Casperdroid5/IoT-WasteBin-prototype/README.md

# WasteBin Project

Het WasteBin Project, ook bekend als de Slimme Vuilnisbak, heeft als doel het probleem van onaangename geuren in kleine leefruimtes, zoals appartementen, aan te pakken, terwijl het efficiënte afvalscheiding en milieubehoud bevordert.

Door de ontwikkeling van een uniek apparaat voorkomt dit project niet alleen onaangename geuren, maar stimuleert het ook gebruikers om verschillende soorten afval te scheiden, wat leidt tot effectievere recycling en een verminderde milieubelasting.

Dit project is ontwikkeld voor [Insyte Technology](https://insyte-technology.nl/).

Please note that the Dutch text provided above translates to English as follows:

# WasteBin Project

The WasteBin Project, also known as the Smart Wastebin, aims to tackle the problem of unpleasant odors in small living spaces, such as apartments, while promoting efficient waste separation and environmental conservation.

By developing a unique device, this project not only prevents unpleasant odors but also encourages users to separate different types of waste, leading to more effective recycling and reduced environmental impact.

This project was developed for [Insyte Technology](https://insyte-technology.nl/).

Please note that most of the text is written in Dutch on request of the company.
