Casperdroid5/IoT-WasteBin-prototype/Documentatie/mainpage.md

WasteBin project                         {#mainpage}
============

## Het creëren van een prototype slimme vuilnisbak als innovatieve oplossing voor geurvrije en milieuvriendelijke afvalverwerking

**Casper R. Tak**

Een product rapport voor het S6 project van het prototype van de slimme vuilnisbak

**Embedded Systems Engineering**
**Hogeschool van Arnhem en Nijmegen**
**Nederland**
**31/05/2023**
