Casperdroid5/IoT-WasteBin-prototype/Documentatie/mosquitto instellen.md

# Handleiding voor het opzetten van de Mosquitto Broker

Deze handleiding biedt begeleiding bij het instellen en gebruiken van de Mosquitto broker met het meegeleverde script. De Mosquitto broker maakt communicatie mogelijk tussen het apparaat en andere MQTT-clients. Volg de onderstaande instructies om de benodigde instellingen te configureren voor succesvolle communicatie.

## Vereisten

- Arduino-bord (bijv. ESP32)
- Arduino IDE
- Geïnstalleerde en actieve Mosquitto broker

## Configuratie van het script

Open het script (`.ino`-bestand) in de Arduino IDE en zoek het volgende gedeelte:

```cpp
// WiFi-instellingen
const char* SSID = "WWegvanons3";       ///< SSID van het WiFi-netwerk
const char* PASSWORD = "JuCasSan27@#";  ///< Wachtwoord voor het WiFi-netwerk

// MQTT Broker-instellingen
const char* MQTT_SERVER = "192.168.111.237";  ///< IP-adres van de MQTT broker-server
const char* MQTT_USERNAME = "mqtt";           ///< Gebruikersnaam van de MQTT broker
const char* MQTT_PASSWORD = "WasteBin5#";     ///< Wachtwoord van de MQTT broker
const int MQTT_PORT = 1883;                   ///< Poortnummer van de MQTT broker
```

1. **WiFi-instellingen**: Werk de `SSID`- en `PASSWORD`-variabelen bij met de gegevens van jouw WiFi-netwerk.

2. **MQTT Broker-instellingen**: Wijzig de `MQTT_SERVER`, `MQTT_USERNAME`, `MQTT_PASSWORD` en `MQTT_PORT`-variabelen om overeen te komen met jouw Mosquitto broker-configuratie. De `MQTT_SERVER` moet het IP-adres of de hostnaam van jouw MQTT broker bevatten.

# De instellingen van de Mosquitto Broker

Deze instellingen hebben betrekking op de algemene configuratie van de Mosquitto broker (bestand: mosquitto.conf). Laten we elk van de instellingen doornemen en hun betekenis:

- `allow_anonymous`: Deze instelling bepaalt of anonieme clients (clients zonder authenticatie) verbinding mogen maken met de broker. In dit geval is het ingesteld op `false`, wat betekent dat anonieme clients niet zijn toegestaan.

- `listener`: Deze optie specificeert het poortnummer waarop de broker luistert naar inkomende MQTT-verbindingen. De waarde `1883` geeft aan dat de broker luistert op poort 1883 voor MQTT-verkeer.

- `password_file`: Deze instelling specificeert het pad naar het wachtwoordbestand dat wordt gebruikt voor authenticatie. Het wachtwoordbestand bevat gebruikersnamen en bijbehorende wachtwoorden voor clients die verbinding mogen maken met de broker.

Door `allow_anonymous` op `false` in te stellen en een `password_file` te specificeren, zorgt de configuratie ervoor dat alleen geauthenticeerde clients met geldige referenties verbinding kunnen maken met de broker. Dit verbetert de beveiliging door ongeautoriseerde toegang te voorkomen.

Het is belangrijk op te merken dat deze instellingen deel uitmaken van de algemene configuratie en dat er mogelijk aanvullende instellingen specifiek voor de Mosquitto broker zijn die niet worden weergegeven in het verstrekte fragment.

# Verbinding maken met de Mosquitto Broker

Om het IoT-apparaat met de Mosquitto broker te verbinden, zorg ervoor dat de broker actief is en toegankelijk is vanaf het netwerk van het IoT-apparaat. Volg deze stappen:

1. **WiFi-verbinding instellen**: Het script bevat een `setupWiFi()`-functie die de verbinding met jouw WiFi-netwerk afhandelt. Het maakt automatisch verbinding met behulp van de opgegeven `SSID` en `PASSWORD`. Zorg ervoor dat het  IoT-apparaat binnen het bereik van jouw WiFi-netwerk bevindt.

2. **MQTT-client configureren**: Het script heeft een `setupMQTTClient()`-functie die de MQTT-client configureert met de opgegeven broker-instellingen. Controleer of de `MQTT_SERVER`, `MQTT_USERNAME`, `MQTT_PASSWORD` en `MQTT_PORT`-variabelen overeenkomen met jouw Mosquitto broker-configuratie.

3. **Uploaden en uitvoeren**: Upload het aangepaste script naar het  IoT-apparaat en bekijk de Seriële Monitor voor de verbindingsstatus en eventuele foutmeldingen.

4. **Verbinding verifiëren**: Nadat het script succesvol is geüpload, zou het  IoT-apparaat proberen verbinding te maken met de Mosquitto broker. Controleer de Seriële Monitor op het bericht "

WiFi connected" gevolgd door het toegewezen IP-adres van het IoT-apparaat. Als de verbinding mislukt, zorg er dan voor dat de broker-instellingen en WiFi-inloggegevens correct zijn.

## Interactie met de Mosquitto Broker

Het script voert de volgende taken uit:

- Leest sensordata uit een SHT4x-sensor.
- Update de positie van de deksel op basis van de status van een knop.
- Bestuurt een Peltier-module op basis van temperatuurfout.
- Publiceert sensordata naar de MQTT-broker.

Om te communiceren met de Mosquitto broker en gegevens te ontvangen die door het IoT-apparaat zijn gepubliceerd, heb je een MQTT-client nodig, zoals MQTT.fx, MQTT Explorer of een aangepaste toepassing.

1. **Inschrijven op sensordata**: Abonneer je in jouw MQTT-client op het onderwerp dat is gespecificeerd in de `SENSOR_DATA_TOPIC`-variabele ("/data/sensors/"). Hiermee kun je sensordata ontvangen die door het IoT-apparaat is gepubliceerd.

2. **MQTT-berichten controleren**: Bekijk in jouw MQTT-client de inkomende berichten van het IoT-apparaat op het geabonneerde onderwerp. De ESP32 zal periodiek sensordata publiceren op basis van de `msg_interval`-variabele.

## Conclusie

Door de instructies in deze handleiding te volgen, kun je de Mosquitto broker en het bijbehorende IoT-apparaat script configureren om communicatie tot stand te brengen tussen het IoT-apparaat en MQTT-clients.
