Casperdroid5/IoT-WasteBin-prototype/Documentatie/IoT oplossing.md

# Het Gebruik van meerdere ESP32-Microcontrollers met Node-Red en een Database

## Inleiding

Meerdere ESP32-microcontrollers kunnen in combinatie met Node-Red worden gebruikt om een visuele interface te bouwen op basis van de gegevens die zijn gelogd door de ESP32. Elke ESP32 kan worden geconfigureerd om gegevens van een specifieke sensor of apparaat te loggen en deze via Wi-Fi naar Node-Red te verzenden. Node-Red kan vervolgens de gegevens ontvangen en verwerken met behulp van verschillende nodes.

Al deze informatie moet vervolgens worden opgeslagen in een database, zodat de gegevens kunnen worden opgevraagd van de testpersonen en sensoren.

## Doel

Het opzetten van een systeem waarbij meerdere ESP32-microcontrollers worden gebruikt om gegevens naar Node-Red te verzenden voor visualisatie en verwerking.

Het vervolg hierop is alle gegevens vanaf Node-Red weer door te sturen naar een database.

## Onderbouwing keuze ESP32 C3

Wij kiezen voor een ESP32 omdat deze de volgende voordelen biedt:

- Relatief goedkoop (€2 per stuk).
- Beschikbaarheid (1300 op voorraad bij Mouser, afhankelijk van het model).
- Geschikt voor de taken die moeten worden uitgevoerd.
- Compact formaat.

## Waarom geen Arduino of Raspberry Pi als computer voor de WasteBin?

Raspberry Pi's zijn momenteel moeilijk verkrijgbaar, duur in aanschaf voor een testplatform en vereisen meer inspanning om op te zetten. Bovendien zijn ze vaak te krachtig voor onze doeleinden en daardoor overbodig qua rekenkracht.
Arduino's zijn redelijke alternatieven, maar duurder en beperkter dan  ESP32-modules. Desalniettemin kunnen ESP32-modules via de Arduino IDE worden geprogrammeerd met behulp van de Arduino-codebibliotheken, indien gewenst.

## Data forwarding

Data forwarding is de plaats waar alle data van de ESP32's (of vuilnisbakken) wordt verzameld. Een mogelijke optie is het gebruik van specifieke hardware, zoals een Raspberry Pi met een broker (zoals Mosquitto) en een Node-Red-dashboard.
Wij kiezen ervoor om de broker en het dashboard op onze lokale laptop te installeren in plaats van een Raspberry Pi te gebruiken. We hebben hiervoor meerdere redenen:

1. We vermijden de noodzaak van een extra apparaat (Raspberry Pi). Alles op één apparaat maakt het eenvoudiger. Bovendien zijn Raspberry Pi's moeilijk verkrijgbaar en vormen ze een extra bron van potentiële hardwarefouten (zoals SD-kaartcorruptie) en softwareproblemen (Linux-problemen) enzovoort.
2. Als we fysiek ergens anders willen werken, zouden we steeds de Raspberry Pi moeten verbinden met het netwerk op die locatie via een beeldscherm en toetsenbord.
3. De Raspberry Pi kan een beveiligingsrisico vormen.
4. Op het moment van schrijven is het erg lastig om aan Raspberry Pi's te komen i.v.m. het chip te kort.

Stappenplan:

1. ESP32-gegevens laten versturen (verbinding maken met internet).
2. Opzetten van een MQTT-broker om de gegevens door te sturen.
3. De MQTT-broker accepteert de gegevens van de ESP32.
4. De MQTT-broker stuurt gegevens door naar Node-Red (lokaal).
5. Inkomende gegevens van de MQTT-broker worden omgezet naar een dashboardweergave.
6. Data van Node-Red doorsturen naar een database.
7. De broker word op een externe computer gedraaid die dag en nacht gegevens doorzend naar Node-Red en de database

## De Data

De volgende gegevens willen we versturen vanaf de ESP32:

- Temperatuur (dubbel)
- Luchtvochtigheid (dubbel)
- Klepstand (boolean)
- Foutcodes (integer)
- WasteBin-ID (macadres)

Deze gegevens worden via MQTT naar Node-Red verzonden. Van daaruit worden de gegevens doorgestuurd naar een SQLite-database. We hebben gekozen voor SQLite vanwege de handige SQLiteStudio-omgeving waarin we de database gemakkelijk kunnen ontwerpen, opbouwen en testen.

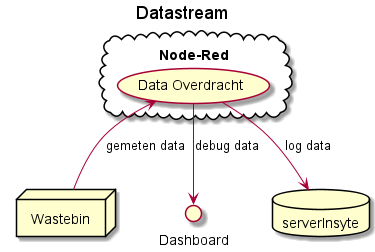
[picture p3: Documentatie/Datastream.png]
Datastream


## Meldingen voor de gebruiker

Voor onze opstelling willen we een luidspreker gebruiken als indicator die verschillende waarschuwingen kan afgeven wanneer dat nodig is. Deze waarschuwingen zijn onder andere:

- De klep staat te lang open (mogelijk)
- De binnenkant van de bak is te warm (mogelijk klep open of slechte koeling)
- Algemene fout (ander probleem)

We hebben ervoor gekozen om deze waarschuwingen ook naar ons dashboard te sturen als ze zich voordoen. Deze waarschuwingen worden weergegeven als foutcodes.

## Verstuur interval

In principe worden alle gegevens elke 15 minuten verstuurd. We denken dat dit voldoende informatie is voor elke vuilnisbak om eventuele problemen te detecteren (bijvoorbeeld te lage temperatuur). Bovendien voorkomt dit dat de database overvol raakt met gegevens, vooral wanneer er 30 vuilnisbakken zijn.

### In geval van fouten

In geval van een fout wordt dit interval genegeerd. Het interval wordt dan 2 minuten, indien er zich één of meerdere fouten blijven voordoen.

## Node-Red

We zullen Node-Red gebruiken om alle gegevens van MQTT te ontvangen, te verwerken en weer te geven. Alle ontvangen informatie wordt weergegeven via een Node-Red UI-tabblad. Dit UI-tabblad, ook wel "dashboard" genoemd in Node-Red, is uitbreidbaar indien gewenst. Alle prototype vuilnisbakken kunnen in real-time worden weergegeven op het dashboard als dat gewenst is.

De Node-Red UI ziet er als volgt uit voor twee vuilnisbakken:

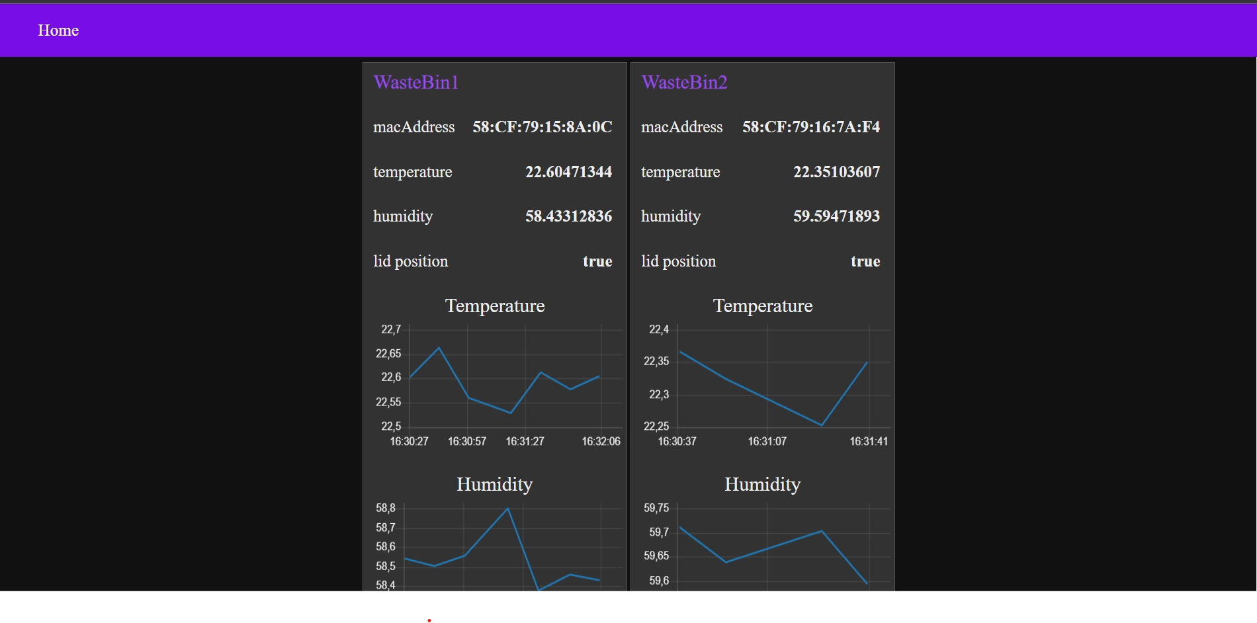
[picture p4: Documentatie/node-red-ui.png]
Node-Red UI


### Node-Red flow

Om dit alles te laten werken, hebben we een Node-Red flow gemaakt. De Node-Red flow ziet er als volgt uit:

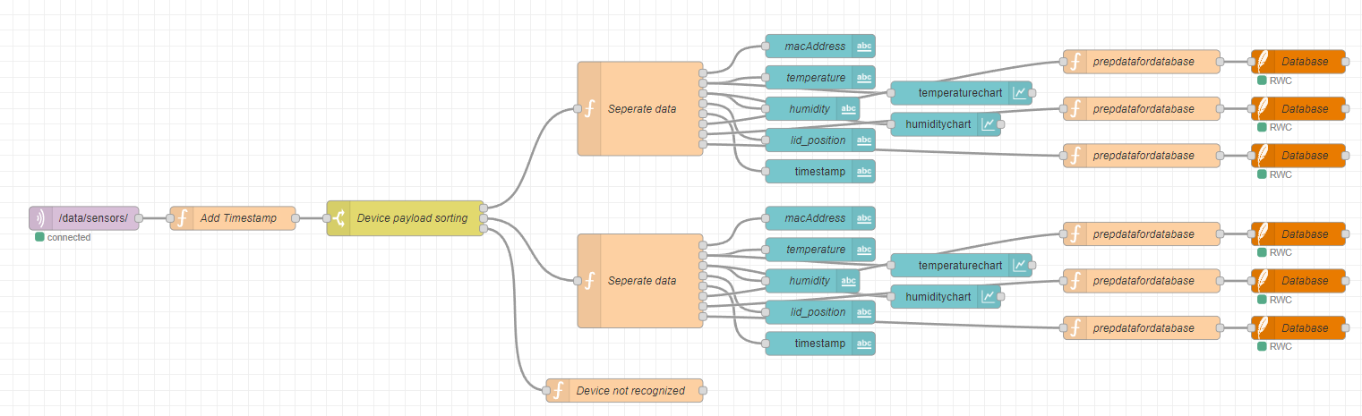
[picture p5: Documentatie/node-red-setup.png]
Node-Red setup


In deze flow ontvangt de eerste node (paars) de MQTT-gegevens. Vervolgens wordt er een tijdstempel aan het bericht toegevoegd en worden alle inkomende berichten gescheiden met behulp van een schakelaar (switch). De gegevens worden gescheiden op basis van het macadres (uniek) van de vuilnisbak.

Nadat de berichten zijn gescheiden, komen ze in een grote functieblok (oranje) dat het bericht analyseert en verdeelt over de uit puts van het functieblok. Ik heb hiervoor gekozen, zodat het functieblok modulair blijft en de uitvoer flexibel is. De uitvoer wordt gestuurd naar dashboardblokken (blauw) en naar nieuwe functieblokken die extra gegevens toevoegen (zoals sensor-ID) en deze als query naar een SQLite-database sturen.

# Database

Alle informatie wordt via Node-Red doorgestuurd naar een SQLite-database. Het doel van de database is om een doorzoekbare geschiedenis van alle ontvangen gegevens van de vuilnisbakken te creëren en een overzicht te bieden van alle gebruikers (testpersonen) en hun gegevens.

De database is als volgt opgebouwd:

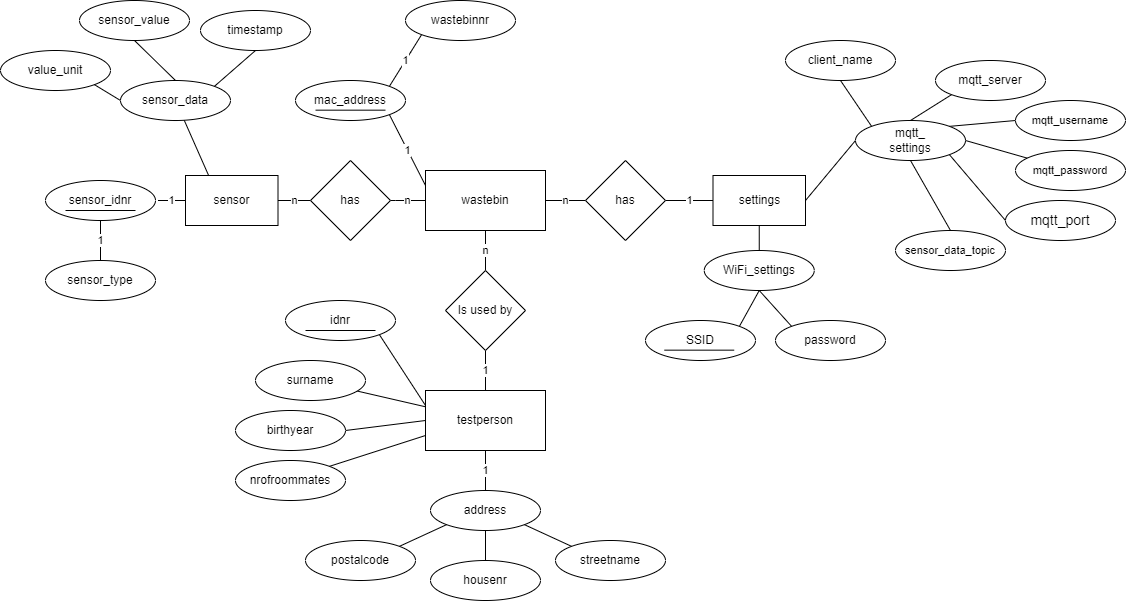
[picture p6: Documentatie/WasteBinDBER.png]
Databaseontwerp


Hierbij zijn alle onderstreepte woorden sleutelwaarden. Helaas toont het Database Entity Relationship-diagram (DBER) niet alle details, maar het geeft wel een goed overzicht van de databasestructuur.

## sensor Table

| Column Name | Data Type | Constraints |
| --- | --- | --- |
| sensor_idnr | INTEGER | PRIMARY KEY |
| sensor_type | TEXT | NOT NULL, UNIQUE |
| sensor_unit | TEXT | NOT NULL |

## sensordata Table

| Column Name | Data Type | Constraints |
| --- | --- | --- |
| mac_address | TEXT | NOT NULL, FOREIGN KEY REFERENCES wastebin(mac_adress) |
| sensor_idnr | INTEGER | NOT NULL |
| sensor_value | INTEGER | NOT NULL |
| timestamp | TEXT | NOT NULL |

## settings Table

| Column Name | Data Type | Constraints |
| --- | --- | --- |
| mac_adress | TEXT | FOREIGN KEY REFERENCES wastebin(mac_adress) |
| SSID | TEXT | NOT NULL |
| password | TEXT | |
| mqtt_server | TEXT | NOT NULL |
| mqtt_username | TEXT | |
| mqtt_password | TEXT | |
| mqtt_port | INTEGER | NOT NULL |
| sensor_data_topic | TEXT | NOT NULL |

## testperson Table

| Column Name | Data Type | Constraints |
| --- | --- | --- |
| idnr | INTEGER | PRIMARY KEY |
| surname | TEXT | NOT NULL |
| birthyear | INTEGER | |
| nrofroommates | INTEGER | |
| postalcode | TEXT | NOT NULL |
| housenr | TEXT | NOT NULL |
| streetname | TEXT | NOT NULL |

## wastebin Table

| Column Name | Data Type | Constraints |
| --- | --- | --- |
| mac_adress | TEXT | FOREIGN KEY REFERENCES testperson(idnr) |
| testperson | INTEGER | PRIMARY KEY |
| wastebinnr | INTEGER | UNIQUE NOT NULL |

Dit is de tabelstructuur voor de database, waarbij elke tabel de bijbehorende velden en datatypes bevat. De tabelrelaties zijn aangegeven met "PRIMARY KEY" en "FOREIGN KEY" om de verbanden tussen de tabellen weer te geven.

De database kan worden doorzocht met behulp van "views" in SQLiteStudio. Deze kunnen door de gebruiker worden gemaakt en aangepast.

Dit is een overzicht van de opzet voor het gebruik van meerdere ESP32-microcontrollers met Node-Red. Met deze configuratie kunnen we gegevens loggen van verschillende sensoren of apparaten, deze visualiseren op een dashboard en ze opslaan in een database voor verdere analyse en beheer.

# Views

Er zijn 3 views beschikbaar gemaakt voor de database.

Deze views zijn gemaakt om een sneller en beter inzicht te krijgen in bepaalde data combinaties.

Hier is een Markdown representatie van de drie views:

## View 1 : view_al_testpersons_with_wastebinnr

```
SELECT tp.*,
       wb.wastebinnr
  FROM testperson AS tp
       JOIN
       wastebin AS wb ON tp.idnr = wb.testperson
```

Deze query selecteert alle kolommen (`*`) uit de `testperson`-tabel en voegt de kolom `wastebinnr` uit de `wastebin`-tabel toe. De JOIN-operatie wordt uitgevoerd op basis van de overeenkomstige `idnr`-kolommen tussen de `testperson`- en `wastebin`-tabellen.

## View 2: view_all_sensors_data

```
SELECT s.sensor_type,
       CASE WHEN sensor_type = "lidposition" AND 
                 sd.sensor_value = 1 THEN 'closed' WHEN sensor_type = "lidposition" AND 
                                                        sd.sensor_value = 0 THEN 'open' ELSE sd.sensor_value END AS sensorvalue,
       sd.timestamp,
       sd.mac_address
  FROM sensor AS s
       JOIN
       sensordata AS sd ON s.sensor_idnr = sd.sensor_idnr
```

Deze query selecteert de kolommen `sensor_type`, `sensorvalue`, `timestamp` en `mac_address`. De `CASE`-expressie wordt gebruikt om de waarde van `sensorvalue` te bepalen op basis van voorwaarden. De JOIN-operatie wordt uitgevoerd op basis van de overeenkomstige `sensor_idnr`-kolommen tussen de `sensor`- en `sensordata`-tabellen.

## View 3: view_all_wastebin_settings

```
SELECT w.wastebinnr,
       w.mac_adress,
       s.SSID,
       s.password,
       s.mqtt_server,
       s.mqtt_username,
       s.mqtt_password,
       s.mqtt_port,
       s.sensor_data_topic,
       w.testperson
  FROM wastebin AS w
       JOIN
       settings AS s ON w.mac_adress = s.mac_adress
```

Deze query selecteert verschillende kolommen uit de `wastebin`- en `settings`-tabellen. De JOIN-operatie wordt uitgevoerd op basis van de overeenkomstige `mac_address`-kolommen tussen de twee tabellen.

De bovenstaande weergave is bedoeld om de query's in een leesbare vorm te presenteren.

Er word aangemoedigd om de views uit te breiden of aan te passen naar wens van de gebruiker.

# Alle Query's

Met al deze Query's is de database opnieuw op te bouwen mocht dit gewenst zijn.

```

-- WasteBinData Database

-- Tabel: sensor
CREATE TABLE sensor (
  sensor_idnr INTEGER PRIMARY KEY,
  sensor_type TEXT NOT NULL UNIQUE,
  sensor_unit TEXT NOT NULL
);

-- Tabel: sensordata
CREATE TABLE sensordata (
  mac_address TEXT NOT NULL REFERENCES wastebin (mac_adress),
  sensor_idnr INTEGER NOT NULL,
  sensor_value INTEGER NOT NULL,
  timestamp TEXT NOT NULL
);

-- Tabel: settings
CREATE TABLE settings (
  mac_adress TEXT REFERENCES wastebin (mac_adress),
  SSID TEXT NOT NULL,
  password TEXT,
  mqtt_server TEXT NOT NULL,
  mqtt_username TEXT,
  mqtt_password TEXT,
  mqtt_port INTEGER NOT NULL,
  sensor_data_topic TEXT NOT NULL
);

-- Tabel: testperson
CREATE TABLE testperson (
  idnr INTEGER PRIMARY KEY,
  surname TEXT NOT NULL,
  birthyear INTEGER,
  nrofroommates INTEGER,
  postalcode TEXT NOT NULL,
  housenr TEXT NOT NULL,
  streetname TEXT NOT NULL
);

-- Tabel: wastebin
CREATE TABLE wastebin (
  mac_adress TEXT REFERENCES testperson (idnr),
  testperson INTEGER PRIMARY KEY,
  wastebinnr INTEGER UNIQUE NOT NULL
);

-- WasteBin Views

-- View: view_al_testpersons_with_wastebinnr
CREATE VIEW view_al_testpersons_with_wastebinnr AS
SELECT tp.*, wb.wastebinnr
FROM testperson AS tp
JOIN wastebin AS wb ON tp.idnr = wb.testperson;

-- View: view_all_sensors_data
CREATE VIEW view_all_sensors_data AS
SELECT s.sensor_type,
  CASE
    WHEN sensor_type = 'lidposition' AND sd.sensor_value = 1 THEN 'closed'
    WHEN sensor_type = 'lidposition' AND sd.sensor_value = 0 THEN 'open'
    ELSE sd.sensor_value
  END AS sensorvalue,
  sd.timestamp,
  sd.mac_address
FROM sensor AS s
JOIN sensordata AS sd ON s.sensor_idnr = sd.sensor_idnr;

-- View: view_all_wastebin_settings
CREATE VIEW view_all_wastebin_settings AS
SELECT w.wastebinnr,
  w.mac_adress,
  s.SSID,
  s.password,
  s.mqtt_server,
  s.mqtt_username,
  s.mqtt_password,
  s.mqtt_port,
  s.sensor_data_topic,
  w.testperson
FROM wastebin AS w
JOIN settings AS s ON w.mac_adress = s.mac_adress;

```
