Casperdroid5/IoT-WasteBin-prototype/Documentatie/bureaubladonderzoek.md

# Bureaubladonderzoek

## Hypotheses en feiten die baat hebben bij de ontwikkeling van de WasteBin

### Inhoud

- [Achtergrond informatie](#achtergrond-informatie)
- [Feiten](#feiten)
- [Hypotheses](#hypotheses)
- [Hoofd- en deelvragen](#hoofd--en-deelvragen)
- [Aanpak onderzoek en bron analyse](#aanpak-onderzoek-en-bron-analyse)
- [Uitwerking vragen](#uitwerking-vragen)
- [Bibliografie](#bibliografie)

## Achtergrond informatie

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

## Feiten

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

## Hypotheses

| Hypothese | Uitwerking/opmerkingen |
| --- | --- |
| Een gegeven materiaal houd zijn temperatuur beter vast dan lucht. | Thermoskan idee: hoe voller de thermoskan is gevuld met hete drank, hoe langer het duurt voor de inhoud is afgekoeld. Dus lucht ontnemen of de bak vullen met water om de optimale temperatuur makkelijk te behouden. |
| Water geleid temperatuur beter dan lucht. | Door de vuilnisbak met water te vullen en het GFE-afval in een zak hierin te koelen, zal dit een efficiëntere thermische overdracht hebben dan via de lucht. De verspreiding van de geur van het rottingsproces zal door het koelen van het GFE-afval minder snel plaatsvinden. Hierdoor is de ozon-generator overbodig. |
| Het invriezen van het GFE-afval stopt het rottingsproces volledig. | Het invriezen van het GFE-afval zal ervoor zorgen dat de micro-organismen die zich in het afval bevinden niet verder kunnen groeien. Sommige organismen kunnen dit alsnog doen, maar dit gebeurt langzamer en zal in de prullenbak nog niet plaatsvinden. |
| Het ontnemen van (een deel van) de zuurstof in combinatie met een ozon-generator remt het rottingsproces voldoende af. | De combinatie van een ozon-generator en minder zuurstof zal zorgen dat het afval dusdanig lang geremd wordt dat koeling niet nodig is. |

Hoofd- en deelvragen:

Hier zijn de regels in Markdown-formaat:

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

## Aanpak onderzoek en bronanalyse

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

### Uitwerking vragen

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

   Figuur 2 Tijd-temperatuur bogen op basis van opslag kamer temperatuur(Platenius, 1939)

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

Om deze drempels te verlagen en het scheidingsproces te bevorderen, kunnen de volgende maatregelen worden genomen:

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

## Onderzoek naar koelmogelijkheden

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

- Compressor
- Peltier-effect
- Magnetische koeling

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

## Wat weerhoudt veel hoogbouwwoningbewoners ervan om hun GFE-afval te scheiden?

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

- We kunnen proberen de geur van het rottingsproces zoveel mogelijk te verminderen of te stoppen. Dit kan worden bereikt door het vertragen of stoppen van het rottingsproces, of door het verwijderen van de geuren die vrijkomen bij het rottingsproces.
- De specifieke aanpak om dit te bereiken moet nog worden vastgesteld.

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

**Bibliografie**

- Platenius, H. (1939). Effect of temperature on the rate of deterioration of fresh vegetables. Washinton, D.C.: Journal of Agricultural Research.
- Rijksoverheid. (sd). Opgehaald van Rijksoverheid.nl: [https://www.rijksoverheid.nl/onderwerpen/afval/huishoudelijk-afval](https://www.rijksoverheid.nl/onderwerpen/afval/huishoudelijk-afval)
- RIVM. (sd). Smog Door Ozon. Opgehaald van RIVM.nl: [https://www.rivm.nl/smog/smog-door-ozon](https://www.rivm.nl/smog/smog-door-ozon)
- Schoonvelde, G. (sd). Infomil.nl. Opgehaald van Infomil.nl: [https://www.infomil.nl/actueel/nieuws-perspectief-1/verbetering-afvalscheiding-hoogbouw-mits/](https://www.infomil.nl/actueel/n
