Casperdroid5/IoT-WasteBin-prototype/Documentatie/databaseexport.png

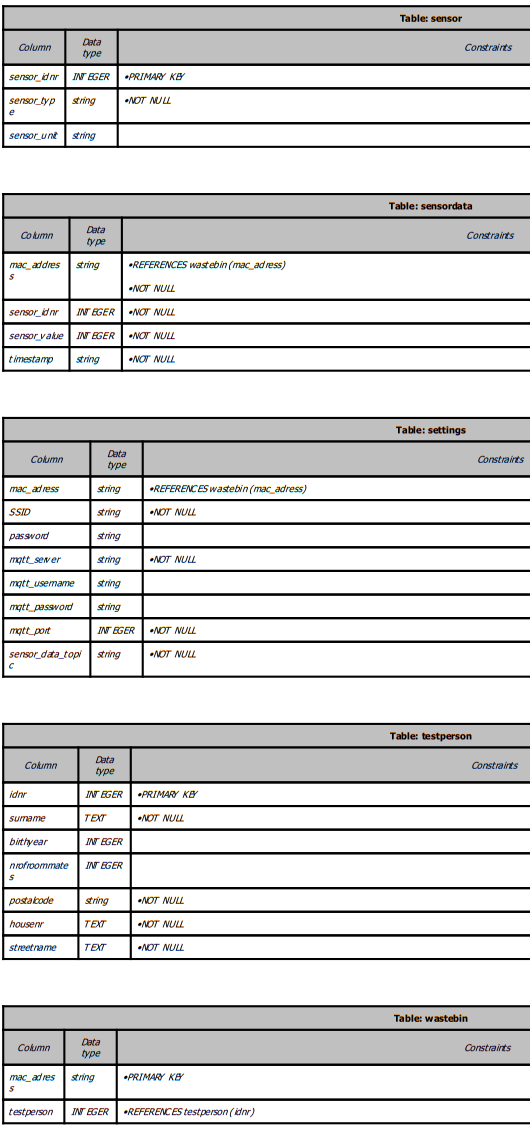
Documentatie/databaseexport.png
