Casperdroid5/IoT-WasteBin-prototype/Documentatie/never gonna give waste up poster.jpg

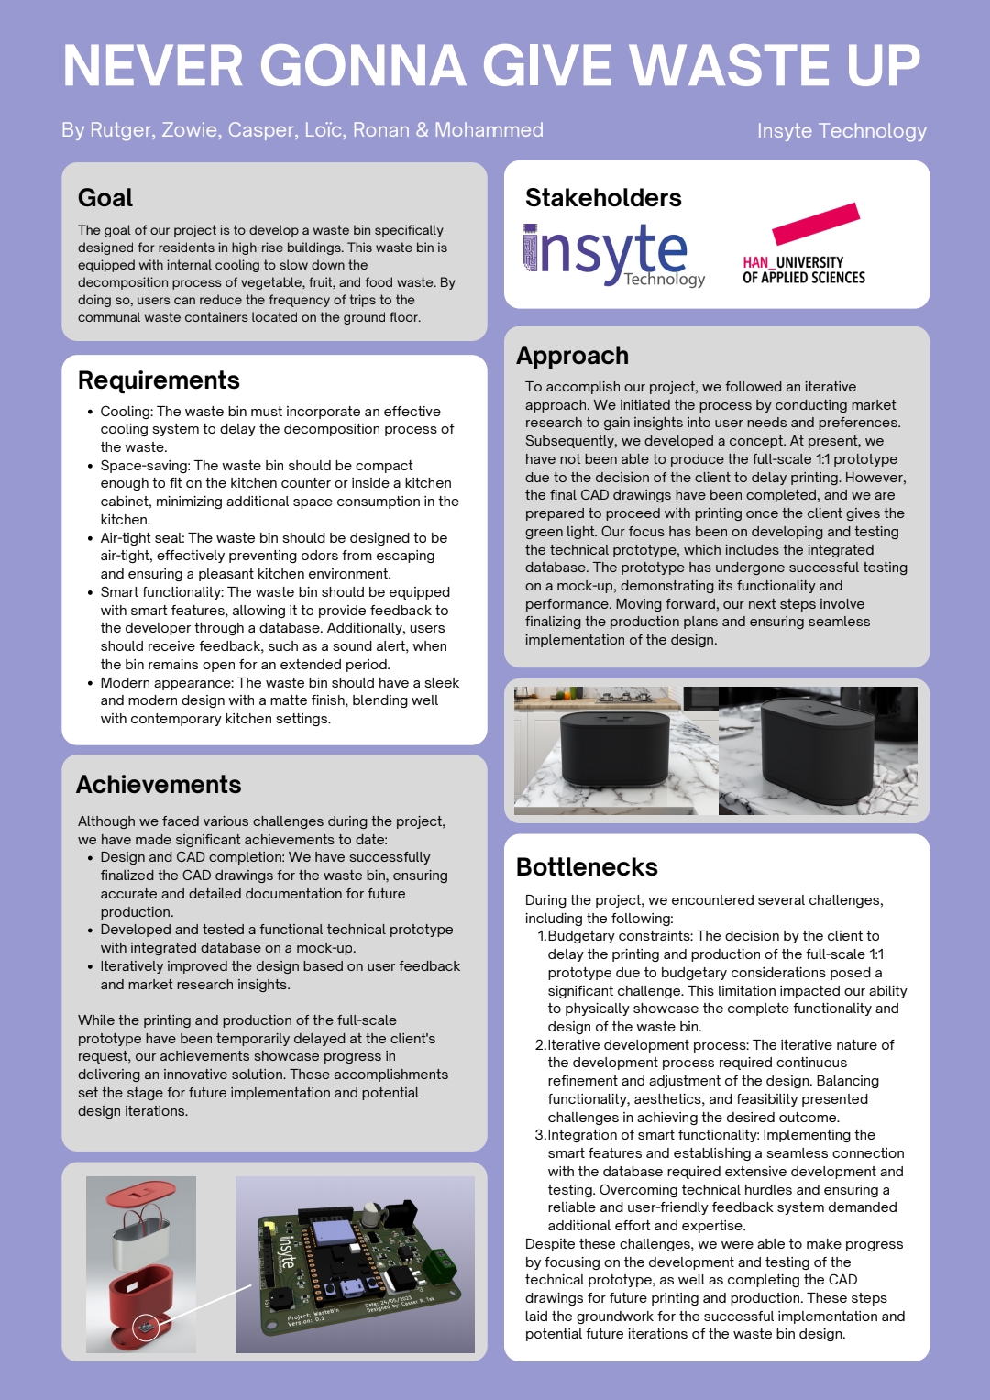
Documentatie/never gonna give waste up poster.jpg
