Casperdroid5/IoT-WasteBin-prototype/Documentatie/sensordata2.png

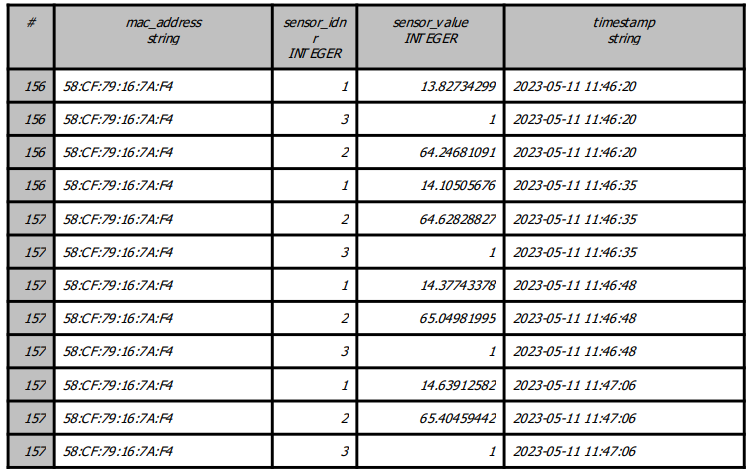
Documentatie/sensordata2.png
