Casperdroid5/IoT-WasteBin-prototype/PCBs/WasteBinPrototypePCB/WasteBinPrototypePCB.kicad_pcb

## KiCad design PCBs/WasteBinPrototypePCB/WasteBinPrototypePCB.kicad_pcb (2023-05-24)

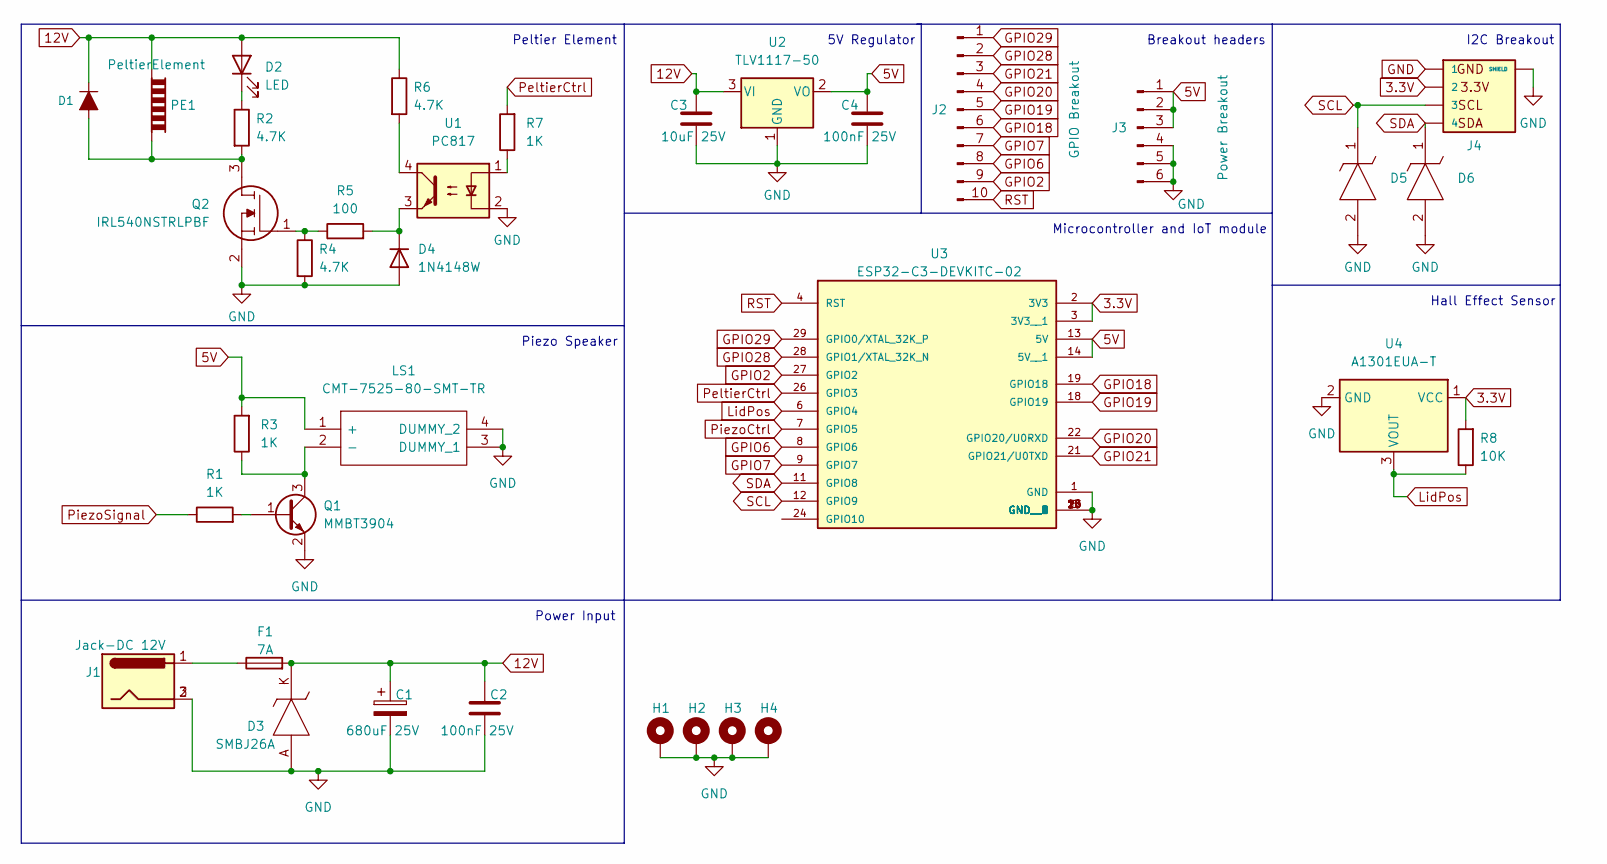
[picture p24: schematic WasteBinPrototypePCB.kicad_sch]

Parts:
C1: 680uF 25V; CP_Elec_8x10; Manufacturer_Part_Number C3339; LCSC C445063
C2, C4: 100nF 25V; C_0805_2012Metric_Pad1.18x1.45mm_HandSolder; LCSC C476766
C3: 10uF 25V; C_0805_2012Metric_Pad1.18x1.45mm_HandSolder; Manufacturer_Part_Number C9807; LCSC C15850
D1: DIODE-1N4148; D_1206_3216Metric_Pad1.42x1.75mm_HandSolder; LCSC C2128
D2: LED; LED_0805_2012Metric_Pad1.15x1.40mm_HandSolder
D3: SMBJ26A; DIOM5436X261N; Mouser Part Number 652-SMBJ26A
D4: 1N4148W; D_SOD-123
D5, D6: ESD7351HT1G; SOD2512X110N; Mouser Part Number 863-ESD7351HT1G
F1: 7A; Fuse_2010_5025Metric_Pad1.52x2.65mm_HandSolder; LCSC C136353
H1, H2, H3, H4: MountingHole_Pad; MountingHole_3.2mm_M3
J1: Jack-DC 12V; BarrelJack_Wuerth_6941xx301002; Mouser 710-694106301002
J2: Conn_01x10_Male; PinSocket_1x10_P2.54mm_Vertical
J3: Conn_01x06_Male; PinSocket_1x06_P2.54mm_Vertical
J4: SM04B-SRSS-TB(LF)(SN); JST_SM04B-SRSS-TB(LF)(SN); LCSC C160404
LS1: CMT-7525-80-SMT-TR; CMT752580SMTTR; Mouser Part Number 490-CMT-7525-80SMTTR
PE1: PeltierElement; TerminalBlock_bornier-2_P5.08mm; Mouser 651-1808190
Q1: MMBT3904; SOT-23
Q2: IRL540NSTRLPBF; IRF2804STRLPBF; Mouser Part Number 942-IRL540NSTRLPBF
R1, R3, R7: 1K; R_0805_2012Metric_Pad1.20x1.40mm_HandSolder
R2, R4, R6: 4.7K; R_0805_2012Metric_Pad1.20x1.40mm_HandSolder
R5: 100; R_0805_2012Metric_Pad1.20x1.40mm_HandSolder
R8: 10K; R_0805_2012Metric_Pad1.20x1.40mm_HandSolder
U1: PC817; DIP-4_W7.62mm
U2: TLV1117-50; SOT230P700X180-4N
U3: ESP32-C3-DEVKITC-02; XCVR_ESP32-C3-DEVKITC-02
U4: A1301EUA-T; PinSocket_1x03_P2.54mm_Vertical

Connections:
3.3V: J4.2, R8.2, U3.2 (3V3), U3.3 (3V3__1), U4.1 (VCC)
5V: C4.2, J3.1, J3.2, J3.3, LS1.1 (+), R3.2, U2.2 (VO), U3.13 (5V), U3.14 (5V__1)
12V: C1.1, C2.1, C3.1, D1.1 (C), D2.2 (A), D3.K, F1.2, PE1.1, R6.1, U2.3 (VI)
GND: C1.2, C2.2, C3.2, C4.1, D3.A, D4.2 (A), D5.2, D6.2, H1.1, H2.1, H3.1, H4.1, J1.2, J1.3, J3.4, J3.5, J3.6, J4.1, J4.S1 (SHIELD), J4.S2 (SHIELD), LS1.3 (DUMMY_1), LS1.4 (DUMMY_2), Q1.2 (E), Q2.2, R4.2, U1.2, U2.1 (GND), U3.1 (GND), U3.5 (GND__1), U3.10 (GND__2), U3.15 (GND__3), U3.16 (GND__4), U3.17 (GND__5), U3.20 (GND__6), U3.23 (GND__7), U3.25 (GND__8), U3.30 (GND__9), U4.2 (GND)
GPIO2: J2.9, U3.27 (GPIO2)
GPIO6: J2.8, U3.8 (GPIO6)
GPIO7: J2.7, U3.9 (GPIO7)
GPIO18: J2.6, U3.19 (GPIO18)
GPIO19: J2.5, U3.18 (GPIO19)
GPIO20: J2.4, U3.22 (GPIO20/U0RXD)
GPIO21: J2.3, U3.21 (GPIO21/U0TXD)
GPIO28: J2.2, U3.28 (GPIO1/XTAL_32K_N)
GPIO29: J2.1, U3.29 (GPIO0/XTAL_32K_P)
LidPos: R8.1, U3.6 (GPIO4), U4.3 (VOUT)
unnamed: D1.2 (A), PE1.2, Q2.3, R2.2
unnamed: D2.1 (K), R2.1
unnamed: D4.1 (K), R5.2, U1.3
unnamed: F1.1, J1.1
unnamed: Q1.1 (B), R1.2
unnamed: LS1.2 (-), Q1.3 (C), R3.1
unnamed: Q2.1, R4.1, R5.1
unnamed: R6.2, U1.4
unnamed: R7.1, U1.1
PeltierCtrl: R7.2, U3.26 (GPIO3)
PiezoCtrl: U3.7 (GPIO5)
PiezoSignal: R1.1
RST: J2.10, U3.4 (RST)
SCL: D5.1, J4.3, U3.12 (GPIO9)
SDA: D6.1, J4.4, U3.11 (GPIO8)

Notes on the sheet:
5V Regulator
Hall Effect Sensor
I2C Breakout
Peltier Element
Microcontroller and IoT module
Power Input
Piezo Speaker
Breakout headers

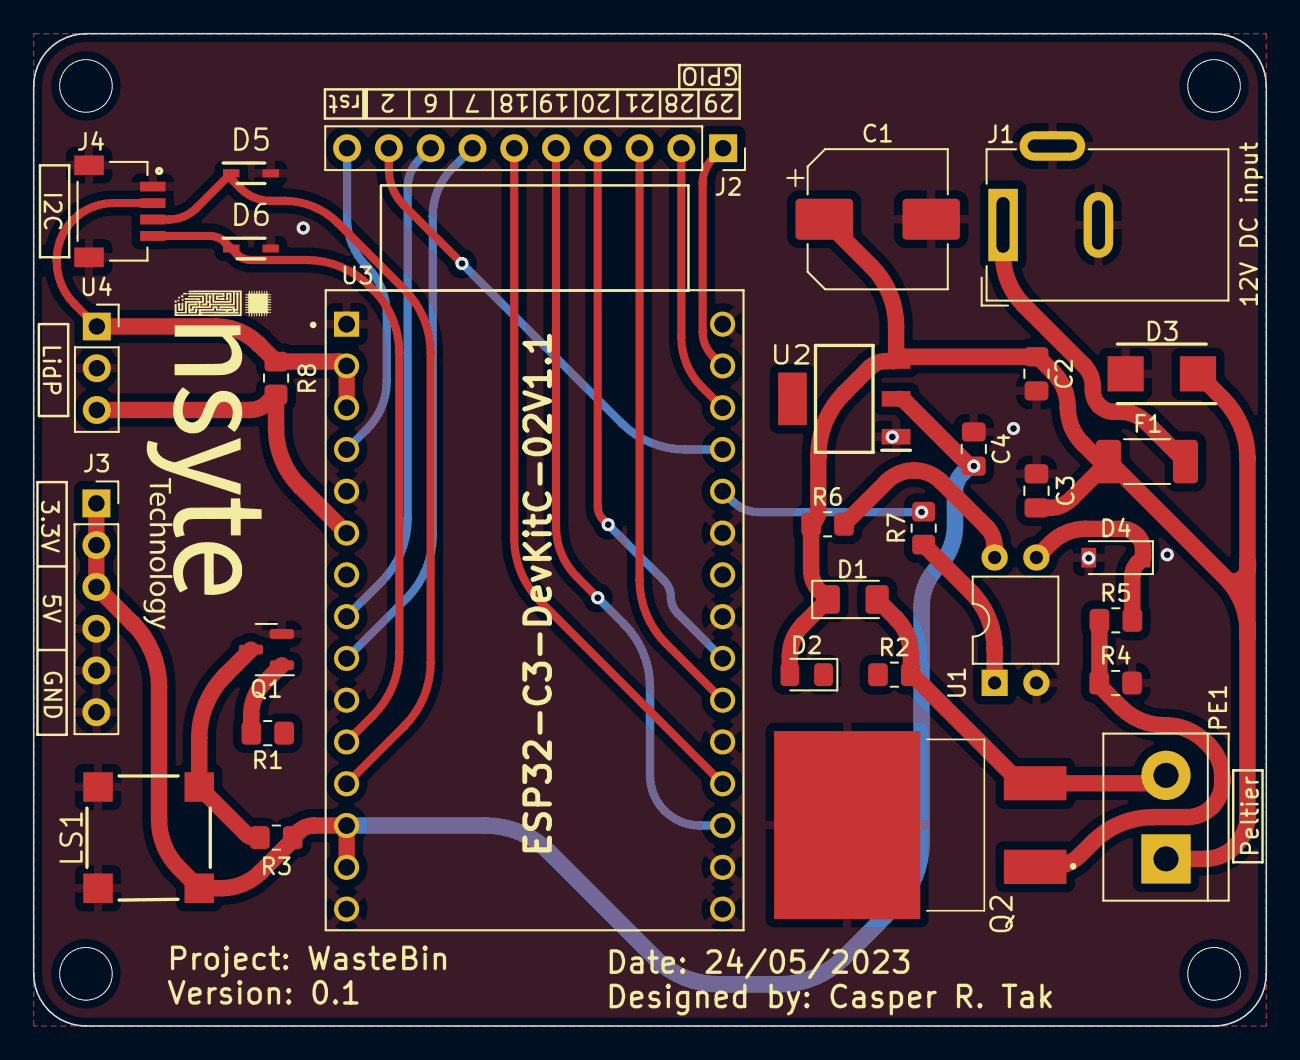
[picture p25: board WasteBinPrototypePCB.kicad_pcb from above]

Board: 2 copper layers, 74.9 x 60.3 mm, 35 parts (0 on the bottom side), 27 nets.
