Casperdroid5/IoT-WasteBin-prototype/(commit log)

2023-02-09 Use case diagram created
2023-02-09 use case diagram
2023-03-16 combined temperature sensor and mqtt code.
2023-03-16 Code is now sending and recieving BMP390 sensor data to MQTT
2023-03-17 code now sends pressure and temperature data in one char array
2023-03-22 functional Node-Red with 2 charts and text for 1 esp32
2023-03-23 Added esp32tohivemq.txt with functional code for wastebin4
2023-03-23 removed esp32tohivemq.txt and transferd data to esp32tohivemq.ino
2023-03-24 Created functional local mqtt broker with coresponding code.
    [esp32tohivemq.ino]
2023-04-12 added lidposition files and inplemented SHT40 sensor (not tested)
2023-04-12 added improved new version of original code. Does not contain sensors
2023-04-12 Improved code without sensors
2023-04-13 changed old program from bmp3XX to SHT40 sensor. Functional with node-red
2023-04-13 implemented sensor code into main WasteBinPrototypeSoftware. Also linked with nodeRed
2023-04-13 simple node-red flow added for latest software
2023-04-14 added new Node-Red/Multiple WasteBinPrototypeSotware flows.json that can support multiple WasteBins at the same time
2023-04-14 added code to control the peltier and fan modules.
2023-04-14 added neopixel (RGB LED) to sketch for visualisation purposes
2023-04-14 removed rgb code (it contained a bug that killed the temperature sensor)
2023-04-17 added control system for temperature control (peltier)
2023-05-10 got database working manually
    [Database tables.xlsx]
2023-05-10 Database integration functional, optimisation needed
    [Database tables.xlsx]
2023-05-10 database structure completed for now. Database filled with data, no sensor data yet
    [Database tables.xlsx]
2023-05-11 fixed the broken piezo speaker code.
    [waste_bin_controller.ino]
2023-05-11 fixed the broken piezo speaker code, but now for real.
    [waste_bin_controller.h, waste_bin_controller.ino]
2023-05-12 cleanup of repository
    [Database tables.xlsx]
2023-05-15 cleanup branch
    [Database tables.xlsx]
2023-05-22 created PCB-design.md and improved on ontwerpkeuzes.md file
2023-05-22 added pcb initialisation
    [WasteBinPrototypePCB.kicad_pcb, WasteBinPrototypePCB.kicad_sch]
2023-05-22 added peltier design to schematic
    [WasteBinPrototypePCB.kicad_sch]
2023-05-22 added piezo speaker to schematic
    [WasteBinPrototypePCB.kicad_sch]
2023-05-22 added Hall effect sensor to schematic
    [WasteBinPrototypePCB.kicad_sch]
2023-05-24 improved on documentation and design
    [WasteBinPrototypePCB.kicad_sch]
2023-05-24 added microcontroller, breakout headers, 5V regulator and i2c vreakout to schematic
    [WasteBinPrototypePCB.kicad_sch]
2023-05-24 added Power input
    [WasteBinPrototypePCB.kicad_sch]
2023-05-24 added name to power input section
    [WasteBinPrototypePCB.kicad_sch]
2023-05-24 improved layout of schematic
    [WasteBinPrototypePCB.kicad_sch]
2023-05-24 footprints assigned to each component
    [WasteBinPrototypePCB.kicad_sch]
2023-05-24 started on pcb design
    [WasteBinPrototypePCB.kicad_pcb, WasteBinPrototypePCB.kicad_sch]
2023-05-24 grouped componentes
    [WasteBinPrototypePCB.kicad_pcb, WasteBinPrototypePCB.kicad_sch]
2023-05-24 added 3d models to components
    [WasteBinPrototypePCB.kicad_pcb]
2023-05-24 created pcb board outline, layed out components and starting retouing wires.
    [WasteBinPrototypePCB.kicad_pcb, WasteBinPrototypePCB.kicad_sch]
2023-05-24 finished wiring and added silkscreen.
    [WasteBinPrototypePCB.kicad_pcb, WasteBinPrototypePCB.kicad_sch]
2023-05-24 finished V0.1, waiting for feedback
    [WasteBinPrototypePCB.kicad_pcb]
2023-05-24 applied rounded tracks design
    [WasteBinPrototypePCB.kicad_pcb]
2023-05-25 improved and added on PCB-design.md documentation
2023-05-25 improved bureaubladonderoek
    [Database tables.xlsx]
2023-05-25 fixed github and removed settings
    [waste_bin_controller.ino]
